WiseLord/volmatrix/files/schematic.png

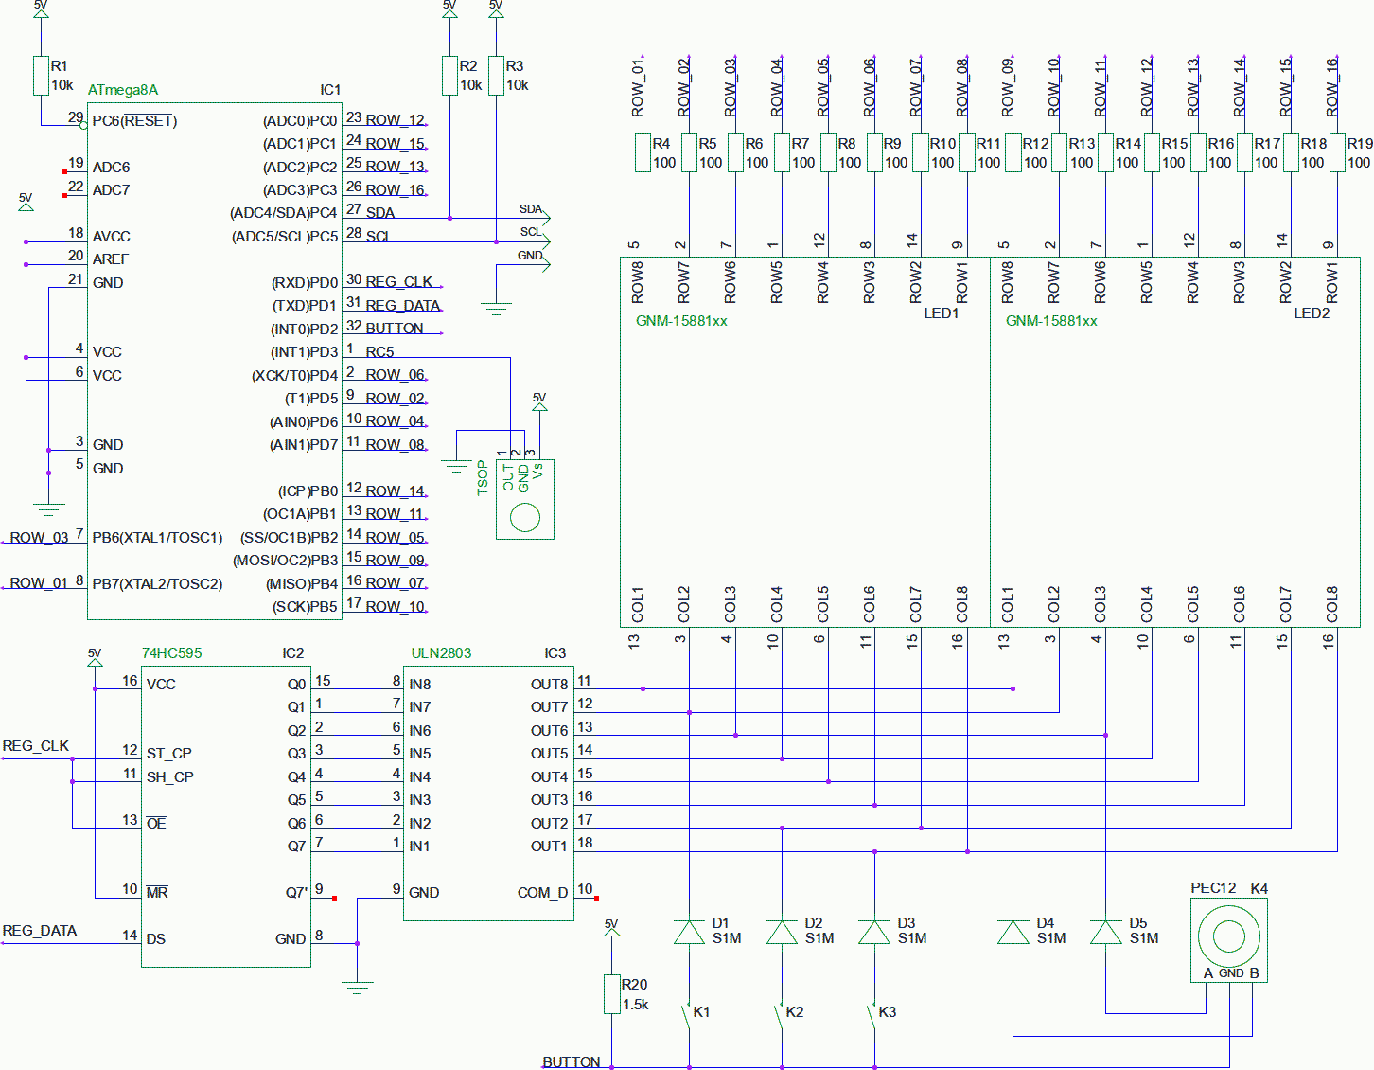
files/schematic.png
