WiseLord/volmatrix/(list of files, drawings)

Other design files:
files/volmatrix.dsn
files/volmatrix.lay6
