WiseLord/volmatrix/src/icons.h

#ifndef ICONS_H
#define ICONS_H

enum {
    ICON_VOLUME = 0,
    ICON_BASS,
    ICON_MIDDLE,
    ICON_TREBLE,
    ICON_PREAMP,
    ICON_FRONTREAR,
    ICON_BALANCE,
    ICON_CENTER,
    ICON_SUBWOOFER,

    ICON_TUNER,
    ICON_PC,
    ICON_TV,
    ICON_DVD,
    ICON_BLUETOOTH,
    ICON_USB,

    ICON_MUTE,
    ICON_LOUDNESS,

    ICON_BR,

    ICON_END
};

extern const uint8_t icons[];

#endif /*ICONS_H */
