WiseLord/volmatrix/(commit log)

2014-12-18 Basic buttons events handling.
2014-12-19 Encoder support.
2015-01-17 Change pinout for test board.
2015-01-17 Fix false brightening when switching rows.
    [matrix.c]
2015-01-17 Set polling freq to 5kHz for better encoder handling.
2015-02-23 Changed pinout for new PCB.
2015-03-29 TDA7448 I2C protocol support.
2016-05-13 Added simulation file
    [volmatrix.dsn]
2016-05-13 Ignore temporary simulation files
    [volmatrix.dsn]
2016-05-13 Fix power on
2016-05-13 Add TDA7448 mix mode (3 x stereo inputs instead of 1 6-ch input. Outputs should be mixed via resistors in this mode
2016-07-31 Some hacks to speed up display scan. It reduces noise (move it to higher freqs).
    [display.c, pins.h, remote.c]
2016-07-31 Fix crashes in some modes on encoder event
    [main.c]
2016-08-02 Check remote control in main loop instead of interrupt
2016-08-20 Add PCB layout
    [volmatrix.lay6]
2016-08-20 Sync I2C code with ampcontrol project
2016-08-21 Refactoring timers
2016-09-16 Added schematic
